LouisRitzenthaler/Led-Decke/(commit log)

2026-10-30 Steuerseite und ESP32-Firmware für die LED-Decke
    Claude-Session: https://claude.ai/code/session_019ZQKxmtvm66y8cHdZq6p5t
2026-10-30 Decke auch mit alter Firmware finden und Hinweis anzeigen
    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
2026-10-30 Namenskonflikt mit NimBLE (BROADCAST) behoben
    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
    [led_decke_esp32.ino]
2026-10-30 Launchpad am Raspberry Pi als Wand-Schaltfeld; Chef nimmt Befehle per UDP an
    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
2026-10-30 Firmware fuer einen einzigen ESP32 mit allen 14 Streifen
    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
2026-10-30 install.sh: Fallback auf pip und klare Fehlermeldung
    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
2026-10-30 install.sh: ERR-Trap auch in der Funktion
    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
2026-10-30 Launchpad: Helligkeit der Kästen sichtbar abgestuft anzeigen
    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
2026-10-30 Launchpad 180° gedreht zur Decke, robustere Verbindung (Timeout, alte Antworten verwerfen), ESP32 bedient UDP zwischen den Streifen
    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
2026-10-30 Pi und ESP32 per Bluetooth statt WLAN
    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
2026-10-30 ESP32 startet immer weiß, Launchpad wartet auf den Zustand der Decke (kein Testmodus mehr)
    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
2026-10-30 ESP32: Bluetooth während OTA-Update trennen
    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
2026-10-31 ESP32: LEDs pro Kasten einzeln einstellbar (erster Kasten 8, zweiter 10)
    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
2026-10-31 Schnelleres Wiederverbinden: Bluetooth-Timeouts am Pi, ESP32 startet Bluetooth vor WLAN
    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
2026-10-31 Handy und Launchpad fragen die Decke öfter ab (schneller sichtbar)
    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
2026-10-31 Bluetooth stabiler: ESP32 schaltet WLAN ab, wenn keins da ist; weniger Abfragen
    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
2026-10-31 Handy-Raster: Reihen und Spalten nochmal umgedreht (Wunsch Louis)
    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
2026-10-31 Musik-Effekte (Puls, Pegel, Beat-Farben) mit Mikrofon an GPIO 34, eigener Bereich auf der Website
    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
2026-10-31 Puls und Pegel reagieren jetzt auch nur auf den Bass
    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
2026-10-31 Neue Bass-Erkennung, Effekt Bass-Wechsel, Mikrofon-Anzeige und Empfindlichkeit auf der Handy-Seite
    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
2026-11-02 Effekt Launchpad-Start (Taste 9h statt Welle), Launchpad-Programm für ESP32-S3
    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
2026-11-02 S3: USB-Geräte freigeben (enum filter), Fehler-Ausgabe
    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
2026-11-02 S3: verbindet sofort, sobald die Decke gefunden ist
    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
2026-11-04 S3: eigene USB-Anmeldung wie am PC (zuerst 64 Byte, zweiter Reset)
    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
    [launchpad_s3.ino]
2026-11-04 S3: USB-Typen ganz nach oben (Arduino-IDE-Prototypen)
    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
2026-11-09 Weiß: bis 50 % nur die weiße LED, darüber kommt RGB dazu
    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
2026-11-09 Handy-Seite: Weißtöne warm, weiß (nur weiße LED) und rein (ohne Gelbstich)
    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
2026-11-09 Mini-System: Einrichtung ohne Internet von der SD-Karte, disable-bt automatisch auskommentieren
    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
